TegarBS/Capstone-Automated-Battery-Spot-Welding-Machine/Hardware/CAD Design.PNG

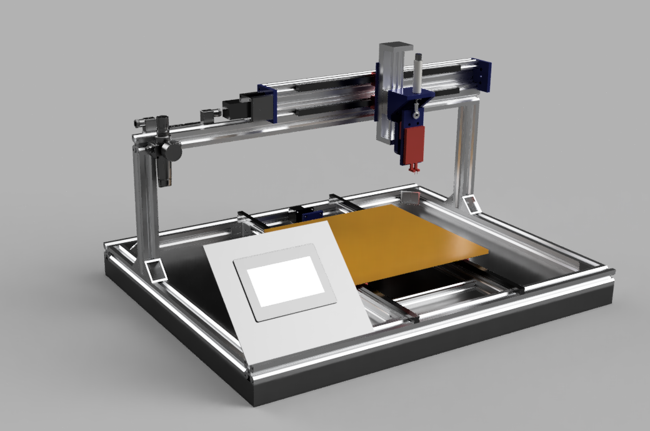
Hardware/CAD Design.PNG
