TegarBS/Capstone-Automated-Battery-Spot-Welding-Machine/Hardware/PCB Render.png

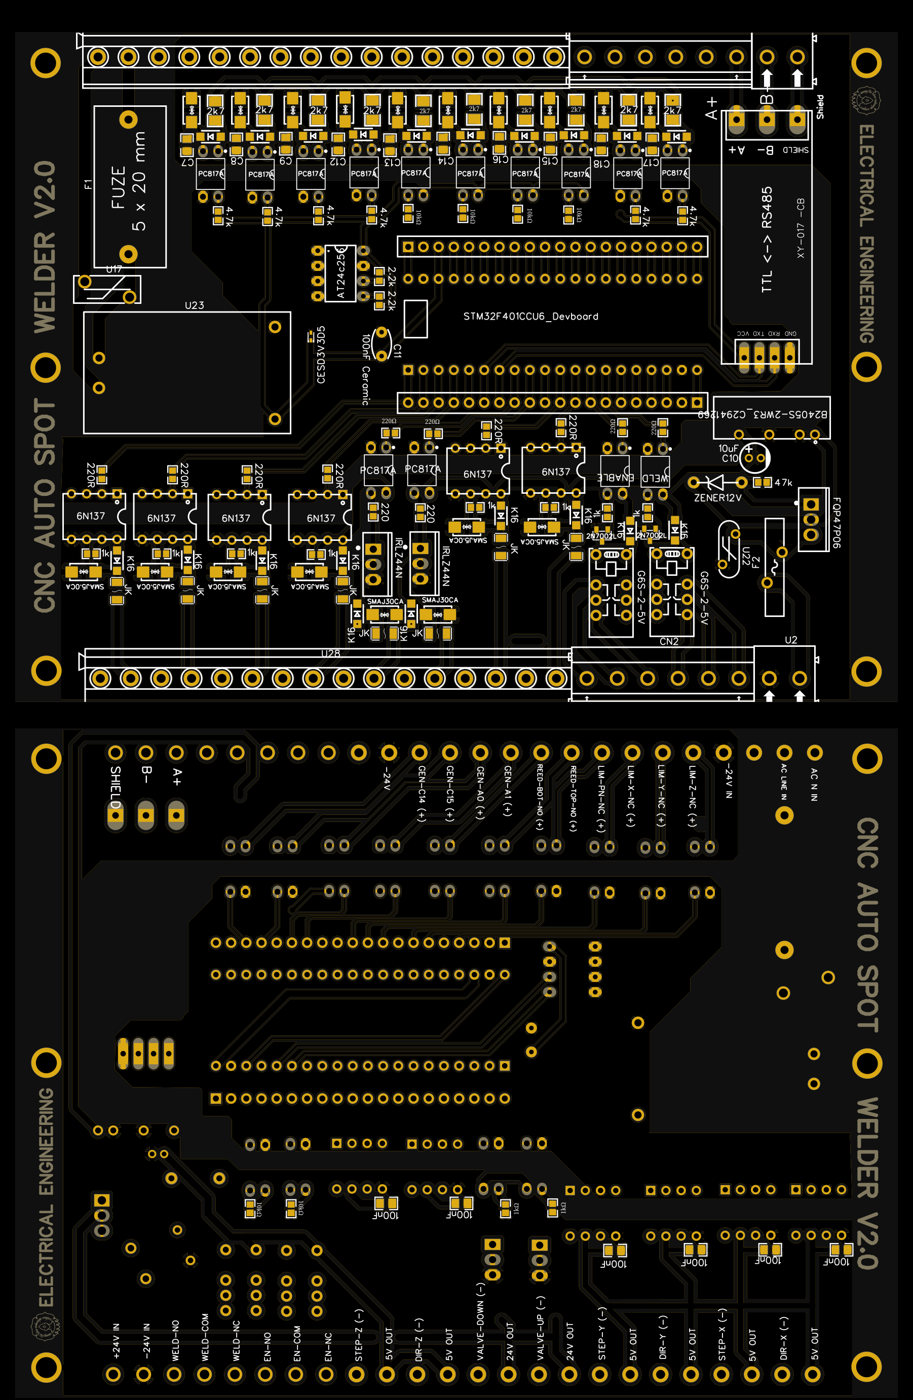
Hardware/PCB Render.png
