TegarBS/Capstone-Automated-Battery-Spot-Welding-Machine/Hardware/Schematic.png

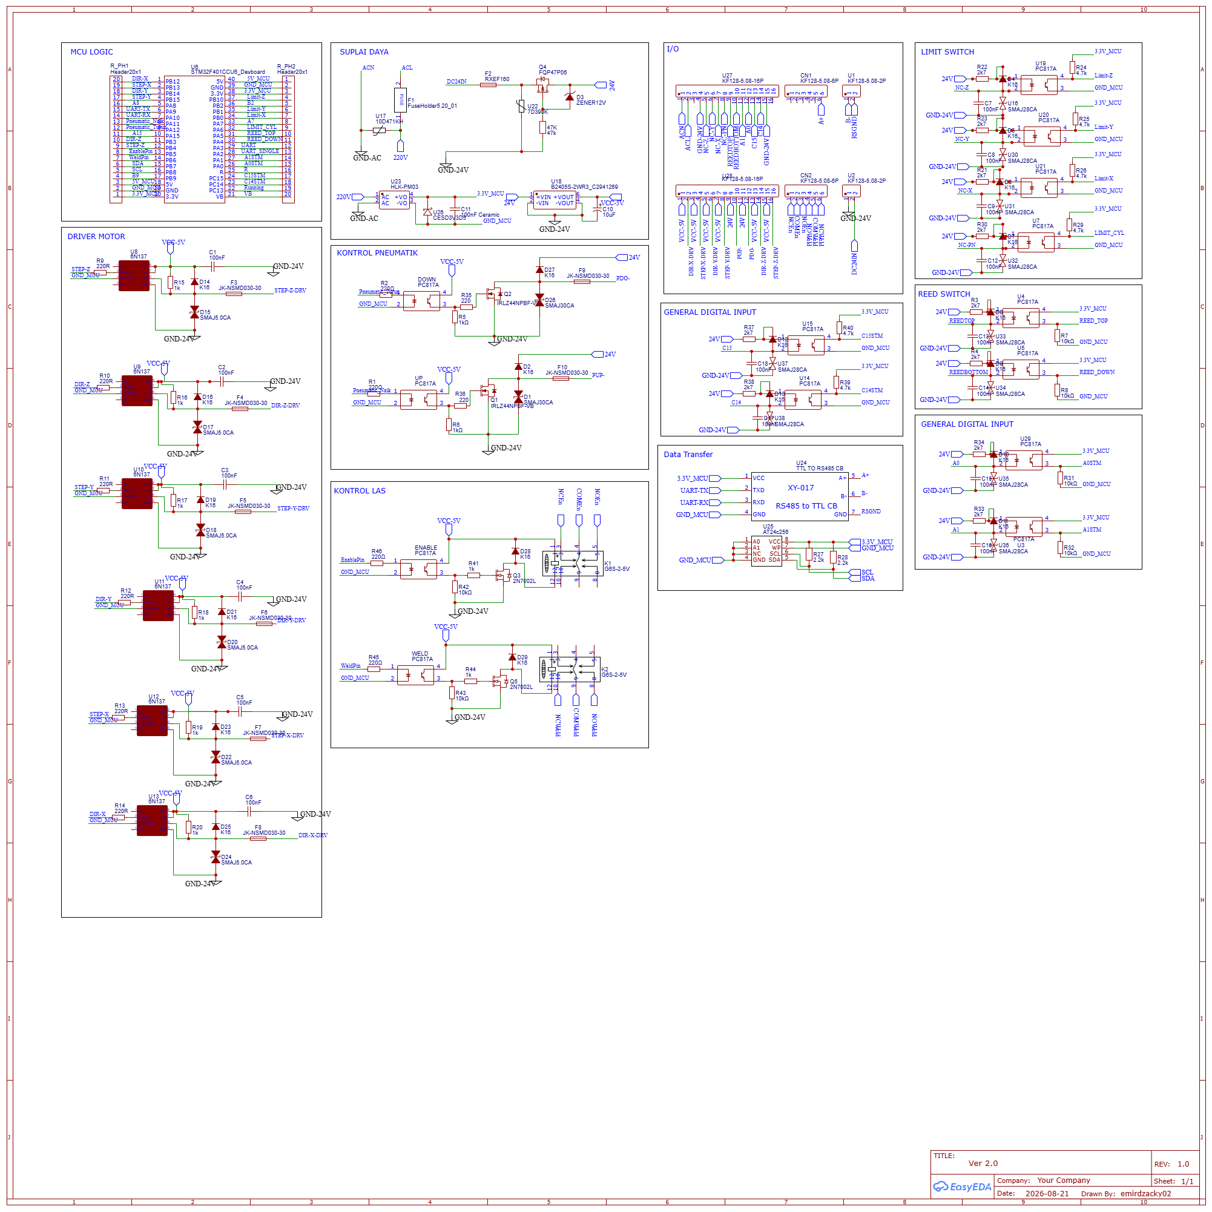
Hardware/Schematic.png
