TegarBS/Capstone-Automated-Battery-Spot-Welding-Machine/Capstone/Core/Src/StepperMotor.h

#ifndef SRC_STEPPERMOTOR_H_
#define SRC_STEPPERMOTOR_H_

#include "main.h"
#include <stdlib.h> // Untuk abs()

enum MotionState {
    IDLE_STATE,
    ACCELERATING,
    CRUISING,
    DECELERATING
};

class StepperMotor {
private:
    GPIO_TypeDef* stepPort;
    uint16_t stepPin;
    GPIO_TypeDef* dirPort;
    uint16_t dirPin;
    TIM_HandleTypeDef* htim; // Pointer ke Hardware Timer (TIM2 / TIM3)

    int32_t currentPositionPulse;
    int32_t targetPositionPulse;
    int32_t invertDir;

    uint32_t timerClock; // Kecepatan clock timer

    // --- Variabel Dynamic ARR (Akselerasi Trapesium) ---
    MotionState state;
    int32_t stepsToGo;
    int32_t accelSteps;

    // --- Variabel Pergerakan ---
    float minSpeedHz;       // Frekuensi awal saat motor mulai bergerak
    float maxSpeedHz;       // Frekuensi puncak / cruising
    float currentSpeedHz;   // Frekuensi aktual saat ini
    float deltaSpeedHz;    	// Lonjakan frekuensi per langkah
    
    float accelHz;

    bool isMoving_flag;

    int32_t maxPositionLimitPulse;


public:
    bool isHomed;
    bool isMoving(void);

    // Constructor kini meminta input Hardware Timer
    StepperMotor(GPIO_TypeDef* step_port, uint16_t step_pin, GPIO_TypeDef* dir_port, uint16_t dir_pin, TIM_HandleTypeDef* timer);

    void setTargetPulse(long target);
    void setInvertDirection(bool invert);

	void setMinSpeedHz(float inputMinSpeedHz);
    void setMaxSpeedHz(float inputMaxSpeedHz);
	void setAccelHz(float inputAccelHz);

	void setMaxPositionLimitPulse(long maxPulse);

    // Fungsi ini BUKAN dipanggil dari loop, tapi langsung oleh Interupsi Timer!
    void isr_update(void);

    void stop(void);
    void resetPosition(void);
    long getCurrentPositionPulse(void);
    void setAsHome(void);
    void unlockPosition(void);
};

#endif /* SRC_STEPPERMOTOR_H_ */
