TegarBS/Capstone-Automated-Battery-Spot-Welding-Machine/Capstone/Core/Src/MachineApp.h

/*
 * MachineApp.h
 *
 *  Created on: Jul 13, 2026
 *      Author: Tegar
 */

#ifndef SRC_MACHINEAPP_H_
#define SRC_MACHINEAPP_H_

#ifdef __cplusplus
extern "C" {
#endif

// Deklarasi fungsi utama yang akan dieksekusi mesin
void MachineApp_Init(void);
void MachineApp_Loop(void);

#ifdef __cplusplus
}
#endif

#endif /* SRC_MACHINEAPP_H_ */
