TegarBS/Capstone-Automated-Battery-Spot-Welding-Machine/Capstone/Core/Src/GlobalData.cpp

/*
 * GlobalData.cpp
 *
 *  Created on: Jul 25, 2026
 *      Author: Tegar
 */

#include "GlobalData.h"

volatile uint16_t errorCallback = 0;

volatile uint16_t errorCode = 0;

// =========================================================
// [STRUCT PARAMETER PERMANEN (EEPROM)]
// =========================================================
PermanentSettings_t eepromSettings = {0}; // Nilai awal kosong
Odometer_t mesinOdo = {0};

// =========================================================
// 1 [STRUCT & KONSTANTA]
// =========================================================
const uint8_t ACK_OK = 0x01;

GPIO_PinState LIMIT_X_Pressed = GPIO_PIN_SET;
GPIO_PinState LIMIT_Y_Pressed = GPIO_PIN_SET;
GPIO_PinState LIMIT_Z_Pressed = GPIO_PIN_SET;

GPIO_PinState REED_TOP_ON		= GPIO_PIN_SET;
GPIO_PinState REED_BOTTOM_ON	= GPIO_PIN_SET;

// =========================================================
// VARIABEL GLOBAL STATUS & ALARM
// =========================================================
uint16_t kode_alarm_sistem = 0;
// 0 = Normal / Sehat
// 1 = IWDG Reset (Sistem Hang / EMI Strike!)
// 2 = Pin Reset (Tombol Reset Fisik ditekan)
// 3 = Power-On Reset (Baru dicolok listrik)

// =========================================================
// 2 [OBJEK & PERIPHERAL]
// =========================================================

// =========================================================
// 3 [BENDERA KONTROL MESIN (STATE MACHINE)]
// =========================================================
volatile bool isNavigating = false;
volatile bool isPaused = false;
volatile bool isAborted = false;
volatile bool ignoreLimitSwitch = false;
volatile bool isPerformHoming = false;
volatile bool isAutoWeldActive = false;
volatile bool isPerformManualJog = false;
volatile bool isMachineHomed = false;
volatile bool isFirstWeldCycle = false;
volatile bool isPerformWeld = false;
volatile bool isConfigLoaded = false;
volatile bool isSaveOdo = false;
volatile bool isPerformPneuUp = false;
volatile bool isPerformPneuDown = false;

volatile bool isBusy = false;

volatile bool isErrorSave = false;

// =========================================================
// [RTOS HANDLES]
// =========================================================
SemaphoreHandle_t SinyalPosisiTercapai;
SemaphoreHandle_t Sem_DataDiterima;
SemaphoreHandle_t Sem_MintaSave;
SemaphoreHandle_t Sem_WeldDone;
SemaphoreHandle_t Sem_I2C_Rx;

// =========================================================
// [Modbus Communication]
// =========================================================
uint16_t Holding_Registers[TOTAL_HOLDING_REGISTERS]	 = {0};
uint16_t Input_Registers[TOTAL_INPUT_REGISTER]  	 = {0};
uint8_t Coils[TOTAL_COILS]              		     = {0};
uint8_t Discrete_Input[TOTAL_DISCRETE_INPUT]  	     = {0};

uint8_t rxChar;
uint8_t rxBuffer[32]; // Diperbesar sedikit untuk Modbus
uint8_t rxIndex = 0;

// =========================================================
// Tracker CAM Zig-Zag
// =========================================================
MesinConfig_t configLas = {0, 0, 0.0f, 0.0f, 0, 0};
uint16_t indexKolomAktual = 0;
uint16_t indexBarisAktual = 0;

// =========================================================
// Variabel "Detak Jantung" (Heartbeat) untuk setiap Task
// =========================================================
volatile bool heartbeat_Sequencer = false;
volatile bool heartbeat_Komunikasi = false;
