TegarBS/Capstone-Automated-Battery-Spot-Welding-Machine/Capstone/Core/Src/FungsiEEPROM.h

/*
 * FungsiEEPROOM.h
 *
 *  Created on: Jul 30, 2026
 *      Author: Tegar
 */

#ifndef SRC_FUNGSIEEPROM_H_
#define SRC_FUNGSIEEPROM_H_

void Task_Storage(void *pvParameters);

bool Load_Settings_From_EEPROM(void);
bool Save_Settings_To_EEPROM(void);

void Load_Default_Value(void);
void Salin_Data_Ke_Register(void);
void Ambil_Data_Dari_Holding_Register(void);

bool Load_Odometer_From_EEPROM(void);
bool Save_Odometer_To_EEPROM(void);
bool Reset_Odometer_EEPROM(void);

#endif /* SRC_FUNGSIEEPROM_H_ */
