TegarBS/Capstone-Automated-Battery-Spot-Welding-Machine/(commit log)

2026-07-27 Homing Kasar
2026-07-27 Homing Kasar 2
2026-07-31 Double Welding No Error Initial Commit
    [FungsiEEPROM.h, FungsiEEPROOM.cpp, GlobalData.h, MachineApp_Dev.cpp, StepperMotor.cpp, StepperMotor.h]
2026-08-01 Edit Konstruktor Motor, Motor Speed masih 0
2026-08-01 Membuat Motor Z
2026-08-01 Manual Weld ke Manual Jog
2026-08-03 Checkpoint No Error - Menambahkan FC03
    [Communication.cpp, Communication.h, MachineApp_Dev.cpp]
2026-08-03 CheckPoint no Error - Menambahkan FC01
    [Communication.cpp, Communication.h, GlobalData.cpp]
2026-08-03 Checkpoint no Error - Geser Address Coil
    [Communication.cpp]
2026-08-04 Refactor Task Sequencer dan Memisahkan Timer Interupt
2026-08-07 E-Stop di Homing
2026-08-12 Error Callback Komunikasi dan Transmit_IT
    [Communication.cpp, FungsiEEPROM.h, FungsiEEPROOM.cpp, GlobalData.h, MachineApp_Dev.cpp, Monitor.cpp, UtilitasDanPerhitungan.cpp, UtilitasDanPerhitungan.h]
2026-08-13 Mengatasi masalah errorCallback Komunikasi
    [Communication.cpp, GlobalData.cpp, GlobalData.h]
2026-08-14 Mengubah object motor menjadi statis
2026-08-16 CP Menuju DMA
2026-08-16 DMA berhasil
2026-08-16 CheckPoint Manual Weld
2026-08-21 CP Error Reset HMI
    [CapstoneCCU6.ioc, Communication.cpp, FungsiEEPROOM.cpp, GlobalData.cpp, GlobalData.h, MachineApp_Dev.cpp, TimerDanInterupt.cpp]
2026-08-25 CP Menuju DMA I2C
2026-09-04 Pindah pin RELAY UP DOWN
2026-09-24 Mematikan double pulse. WELD menjadi pengganti pedal durasi 300ms
2026-11-02 Z Axis Homed
2026-11-05 Membaca isNavigating di HMI
2026-11-08 Create Schematic
2026-11-12 Perbaikan bug manual jog
    [MachineApp_Dev.cpp]
